nhaynes84/zephyr-smart-radio/cad/ref/enclosure_down.stp

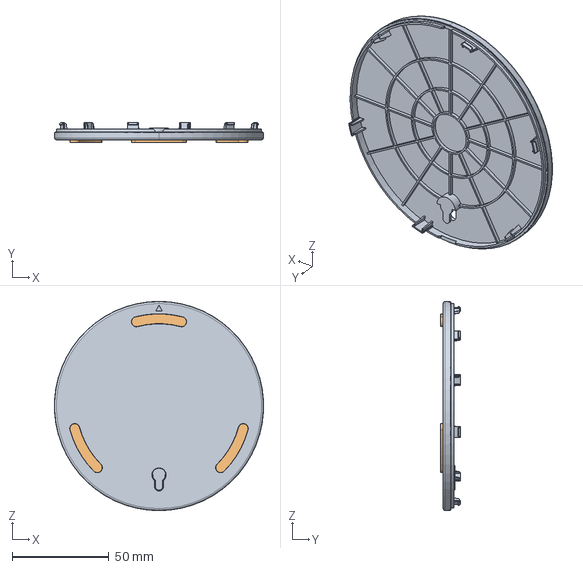
[picture p9: CAD file, 2026-10-31, last stored version]
cad/ref/enclosure_down.stp
107.8 x 10.4 x 108.0 mm
