nhaynes84/zephyr-smart-radio/cad/ref/screen34/3_4inch-DSI-LCD_C.stp

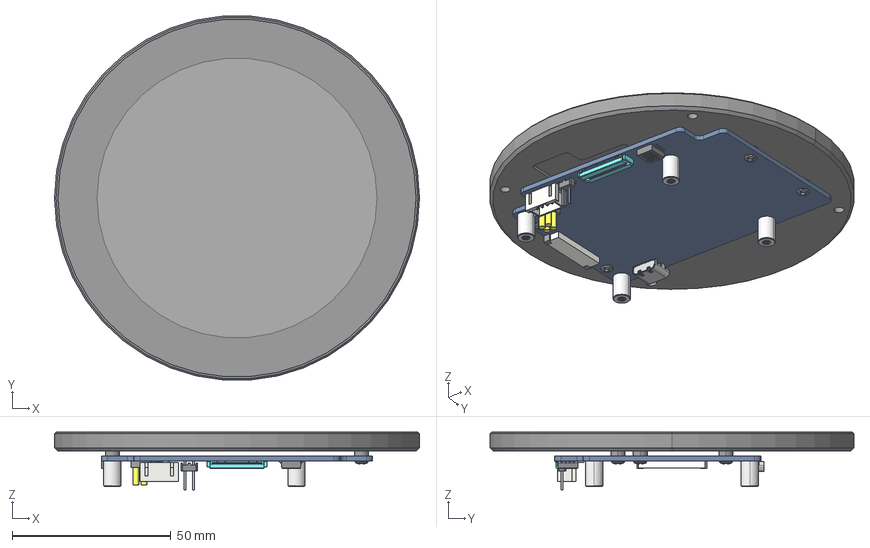
[picture p10: CAD file, 2026-10-31, last stored version]
cad/ref/screen34/3_4inch-DSI-LCD_C.stp
115.0 x 114.7 x 18.2 mm
3_4INCH-DSI-LCD_C-CASE
3_4-4INCH-DSI-LCD_C-PCB
TYPE-C_16PIN-9X3X7_3
30PIN-0_5SH_LCD_CONNECTOR
STUDS-M2_5XH8 x 4
HP2_0-4PIN-SMT-L
2_54_MM_DUPONT_MALE_2PIN-SMT
SWITCH-SMT-TDA04
PM2_5X3-SCREW x 4
