nhaynes84/zephyr-smart-radio/cad/ref/board_xvf3800_xiao.stp

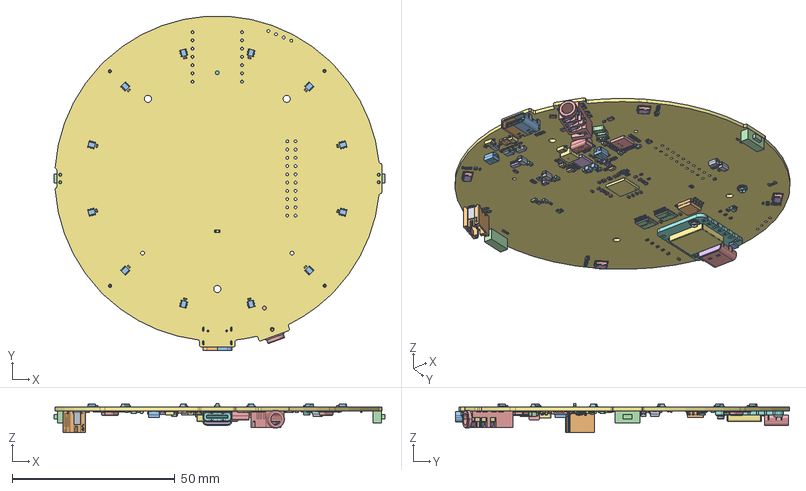
[picture p11: CAD file, 2026-10-31, last stored version]
cad/ref/board_xvf3800_xiao.stp
101.8 x 102.9 x 9.03 mm
C_0402_1005METRIC x 84
WS2812B-2020 x 12
LED_0603_1608METRIC
R_0402_1005METRIC x 81
USER_LIBRARY-SOT323__SC70--7025
USER_LIBRARY-SOT323__SC70-14777
USER_LIBRARY-SOT323__SC70-22914 x 3
SOT-323 x 3
SOT-324 x 3
SOT-325 x 3
SOT-326 x 3
SOT-327 x 3
AVX_BCASE x 2
C_0603_1608METRIC x 13
R_0805_2012METRIC x 3
SOIC-8_5_275X5_275MM_P1_27MM
CRYSTAL_SMD_SEIKOEPSON_FA238V-4
TSSOP14-P065 x 2
ESD0402 x 18
USB_C_RECEPTACLE_GCT_USB4-69789
USB_C_RECEPTACLE_GCT_USB4-69958
USB_C_RECEPTACLE_GCT_USB4-70127
USB_C_RECEPTACLE_GCT_USB4-70296
USB_C_RECEPTACLE_GCT_USB4-70465
USB_C_RECEPTACLE_GCT_USB4-70634
USB_C_RECEPTACLE_GCT_USB4-70803
USB_C_RECEPTACLE_GCT_USB4-70972
USB_C_RECEPTACLE_GCT_USB4-71141
USB_C_RECEPTACLE_GCT_USB4-73106
USB_C_RECEPTACLE_GCT_USB4-73277
USB_C_RECEPTACLE_GCT_USB4-73448
USB_C_RECEPTACLE_GCT_USB4-73619
USB_C_RECEPTACLE_GCT_USB4-73790
USB_C_RECEPTACLE_GCT_USB4-73961
USB_C_RECEPTACLE_GCT_USB4-74132
USB_C_RECEPTACLE_GCT_USB4-74303
USB_C_RECEPTACLE_GCT_USB4-74474
USB_C_RECEPTACLE_GCT_USB4-79560
USB_C_RECEPTACLE_GCT_USB4-79729
USB_C_RECEPTACLE_GCT_USB4-79898
USB_C_RECEPTACLE_GCT_USB4-80067
USB_C_RECEPTACLE_GCT_USB4-80236
USB_C_RECEPTACLE_GCT_USB4-80405
USB_C_RECEPTACLE_GCT_USB4-80574
USB_C_RECEPTACLE_GCT_USB4-80743
USB_C_RECEPTACLE_GCT_USB4-80912
USB_C_RECEPTACLE_GCT_USB4-82877
USB_C_RECEPTACLE_GCT_USB4-83048
USB_C_RECEPTACLE_GCT_USB4-83219
USB_C_RECEPTACLE_GCT_USB4-83390
USB_C_RECEPTACLE_GCT_USB4-83561
USB_C_RECEPTACLE_GCT_USB4-83732
USB_C_RECEPTACLE_GCT_USB4-83903
USB_C_RECEPTACLE_GCT_USB4-84074
USB_C_RECEPTACLE_GCT_USB4-84245
SOT-353_SC-70-5
L2016
L2017
L2018
IM69D130V01XTSA1 x 4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
