nhaynes84/zephyr-smart-radio/cad/ref/enclosure_up.stp

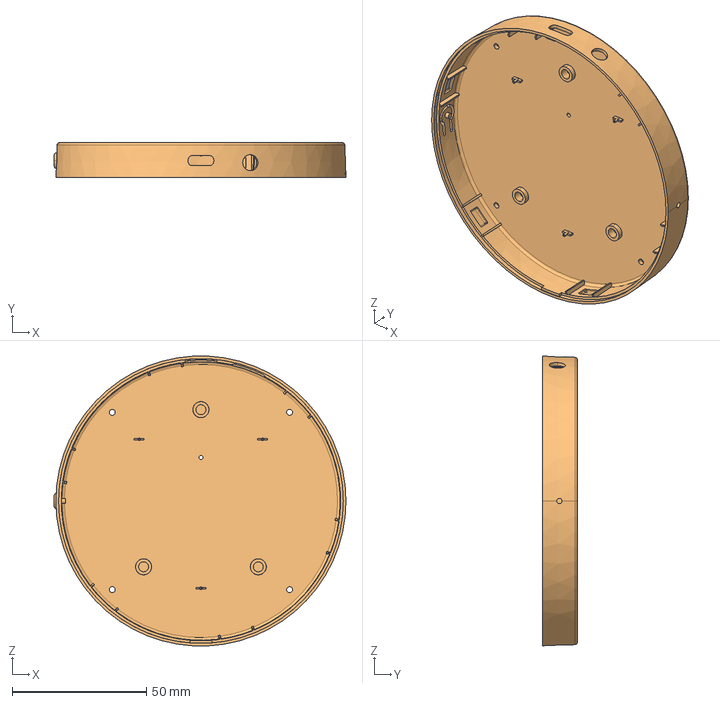
[picture p12: CAD file, 2026-10-31, last stored version]
cad/ref/enclosure_up.stp
108.7 x 13.0 x 107.8 mm
