nhaynes84/zephyr-smart-radio/(commit log)

2026-10-31 Zephyr: split out of home-automation-hub/satellite
    [3_4inch-DSI-LCD_C.stp, board_xvf3800_xiao.stp, enclosure_down.stp, enclosure_up.stp]
2026-10-31 BOM, MIT license, photos
    [3_4inch-DSI-LCD_C.stp, board_xvf3800_xiao.stp, enclosure_down.stp, enclosure_up.stp]
2026-11-03 satd: re-arm the duck failsafe when listening resumes inside DUCK_HOLD_S
    Fixes #1. Reported by @mattabate.
